MatsAndT/brake-timer/Innlevering/7-segment-display.png

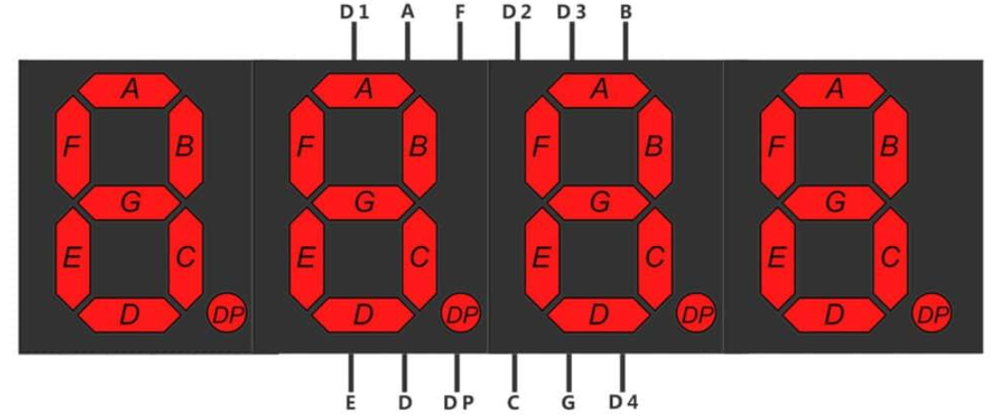
Innlevering/7-segment-display.png
