MatsAndT/brake-timer/Innlevering/Laerer-modul.jpeg

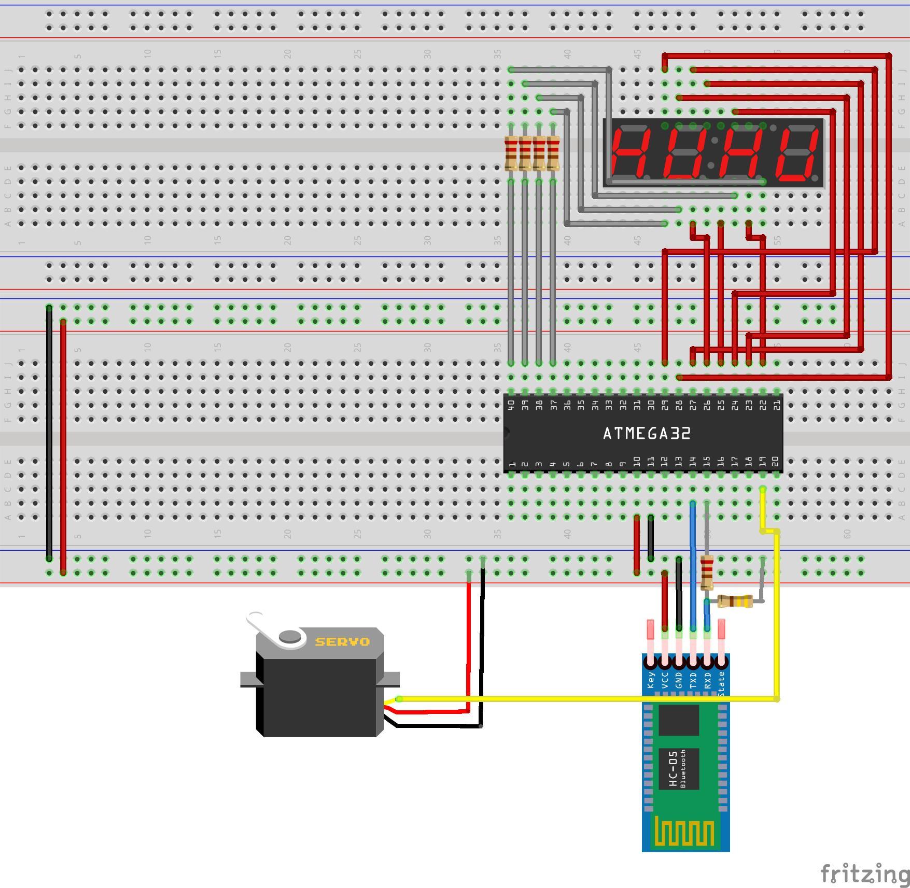
Innlevering/Laerer-modul.jpeg
