MatsAndT/brake-timer/README.md

# brake-timer
This is for the last project in the subject Computer Architecture. The purpose is to create a machine that tells when there is a break in the lecture.
