MatsAndT/brake-timer/Innlevering/KK-modul.png

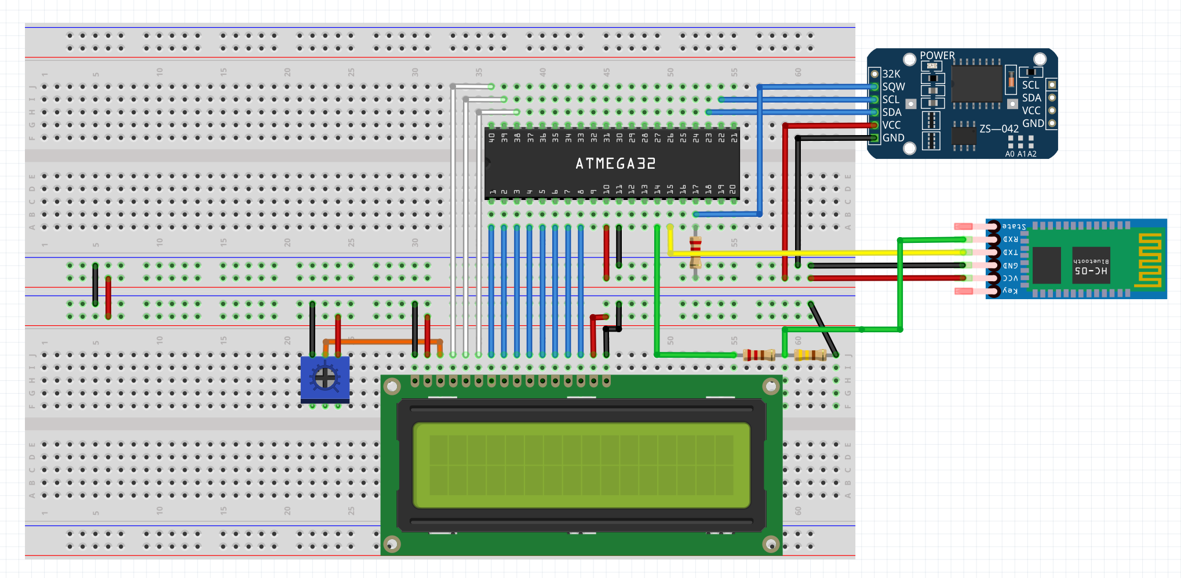
Innlevering/KK-modul.png
