MatsAndT/brake-timer/(commit log)

2024-06-02 fix mota av s
    [main.c]
2024-06-02 timerene stoppes for å spare strøm
